GoTouchGra55/HoG/Kicad/production/bom.csv

Designator | Footprint | Quantity | Value | LCSC Part #
C1, C12, C13, C15, C16, C17, C18, C19, C2, C20, C21, C23, C26, C28, C3, C31, C33, C35, C36, C37, C4, C5, C6 | 0402 | 23 | 100nF
C10, C11, C22, C27, C38, C7 | 0603 | 6 | 10uF
C14, C34 | 0603 | 2 | 1uF
C24 | 0603 | 1 | 33uF
C25 | 0402 | 1 | 75pF
C29 | 0402 | 1 | 56pF
C30 | 0603 | 1 | 44uF
C8, C9 | 0402 | 2 | 18pF
D1, D2 | D_SOD-123 | 2 | D_Schottky
FB1 | 0603 | 1 | FerriteBead
J1 | JST_EH_S5B-EH_1x05_P2.50mm_Horizontal | 1 | DEBUG
J10 | SolderWire-0.5sqmm_1x02_P4.8mm_D0.9mm_OD2.3mm | 1 | ESC_3
J11 | SolderWire-0.5sqmm_1x02_P4.8mm_D0.9mm_OD2.3mm | 1 | ESC_4
J12 | SolderWire-0.5sqmm_1x02_P4.8mm_D0.9mm_OD2.3mm | 1 | ESC_5
J13 | SolderWire-0.5sqmm_1x02_P4.8mm_D0.9mm_OD2.3mm | 1 | ESC_6
J14 | SolderWire-0.5sqmm_1x03_P4.6mm_D0.9mm_OD2.1mm | 1 | Servos
J15 | PinHeader_1x02_P2.54mm_Horizontal | 1 | Power
J16 | PinHeader_1x03_P2.54mm_Vertical | 1 | +5V Pads
J17 | microSD_HC_Hirose_DM3AT-SF-PEJM5 | 1 | Micro_SD_Card_Det1
J18 | PinHeader_1x02_P2.54mm_Horizontal | 1 | AUX
J2 | SHOUHAN_TYPE-C_16PIN_2MD__073_ | 1 | TYPE-C_16PIN_2MD__073_
J3 | JST_EH_S6B-EH_1x06_P2.50mm_Horizontal | 1 | GPS
J4 | JST_EH_S5B-EH_1x05_P2.50mm_Horizontal | 1 | TEL
J5 | SolderWire-0.5sqmm_1x03_P4.6mm_D0.9mm_OD2.1mm | 1 | ESC[1-3]
J6 | SolderWire-0.5sqmm_1x03_P4.6mm_D0.9mm_OD2.1mm | 1 | ESC[4-6]
J7_2, J7 | AMASS_XT60-M_1x02_P7.20mm_Vertical | 2 | POWER
J8 | SolderWire-0.5sqmm_1x02_P4.8mm_D0.9mm_OD2.3mm | 1 | ESC_1
J9 | SolderWire-0.5sqmm_1x02_P4.8mm_D0.9mm_OD2.3mm | 1 | ESC_2
L1 | L_Cenker_CKCS3012 | 1 | 10uH
L2 | L_Cenker_CKCS4030 | 1 | 6.8uH
R1, R15, R16, R17, R18, R19, R20, R21, R22, R23 | 0402 | 10 | 10K
R10, R4 | 0603 | 2 | 400K
R11, R14, R6 | 0603 | 3 | 100K
R12, R5 | 0603 | 2 | 30K
R13 | 0603 | 1 | 22.1K
R2, R3 | 0402 | 2 | 5.1K
R7, R9 | 0402 | 2 | 49.9R
R8 | 0402 | 1 | 13.3K
SW1 | SW_SPDT_PCM12 | 1 | SW_SPDT
SW2 | SW_Push_SPST_NO_Alps_SKRK | 1 | SW_Push
U1 | LQFP-100_14x14mm_P0.5mm | 1 | STM32H743VITx
U2, U3 | IC_ICM-45686 | 2 | ICM-45686
U4 | BMP581 | 1 | BMP581
U5, U6 | SOT-23-6 | 2 | TPS54302
Y1 | Crystal_SMD_3225-4Pin_3.2x2.5mm | 1 | 25MHz
