GoTouchGra55/HoG/Kicad/Telemetry/production/bom.csv

Designator | Footprint | Quantity | Value | LCSC Part #
C1, C14, C28, C32, C37, C46, C5, C50, C6, C8 | 0402 | 10 | 100nF
C10, C29 | 0402 | 2 | 47nF
C11, C30 | 0402 | 2 | 47pF
C12, C13, C51, C52 | 0805 | 4 | 22uF
C15, C31 | 0402 | 2 | 3pF
C16, C34 | 0402 | 2 | 5.6pF
C17, C22, C33, C39 | 0402 | 4 | 39pF
C18, C19, C35, C45 | 0402 | 4 | 1.8pF
C2, C27 | 0603 | 2 | 10uF
C20, C44 | 0402 | 2 | 2.4pF
C21, C49 | 0603 | 2 | 100uF
C23, C24, C40, C41 | 0402 | 4 | 3.3pF
C25, C26, C38, C43 | 0402 | 4 | 1nF
C3, C4, C47, C48 | 0402 | 4 | 15pF
C36, C7 | 0603 | 2 | 1uF
C42, C9 | 0402 | 2 | 470nF
D1, D2 | 0603 | 2 | RED
J1, J5 | PinHeader_1x05_P2.54mm_Horizontal | 2 | DEBUG
J10, J9 | JST_EH_B4B-EH-A_1x04_P2.50mm_Vertical | 2 | Conn_01x04_Pin
J2, J7 | SMA_Amphenol_132134-10_Vertical | 2 | SMA
J3, J8 | PinHeader_1x02_P2.54mm_Horizontal | 2 | POWER
J4, J6 | PinHeader_1x02_P2.54mm_Horizontal | 2 | COMMS
L1, L11 | 0805 | 2 | 15uH
L10, L7 | 0402 | 2 | 9.1nH
L12, L6 | 0402 | 2 | 15nH
L2, L3 | 0402 | 2 | 47nH
L4, L8 | 0402 | 2 | 2.5nH
L5, L9 | 0402 | 2 | 4.7nH
R1, R2, R4, R5 | 0402 | 4 | 100R
R3, R6 | 0402 | 2 | 1k5
SW1, SW2, SW3, SW4 | SW_Push_SPST_NO_Alps_SKRK | 4 | RESET
U1 | TSSOP-20_4.4x6.5mm_P0.65mm | 1 | STM32C011F6Px
U2, U6 | QFN-24-1EP_4x4mm_P0.5mm_EP2.6x2.6mm | 2 | SX1262IMLTRT
U3, U8 | SOT-223-3_TabPin2 | 2 | AMS1117-3.3
U4, U7 | SOT65P215X110-6N | 2 | PE4259
U5 | LQFP-32_7x7mm_P0.8mm | 1 | STM32C031K6Tx
Y1, Y4 | Crystal_SMD_3225-4Pin_3.2x2.5mm | 2 | 48MHz
Y2, Y3 | Crystal_SMD_3225-4Pin_3.2x2.5mm | 2 | 32MHz
