GoTouchGra55/HoG/Kicad/Telemetry/HoG_Telemetry.pdf

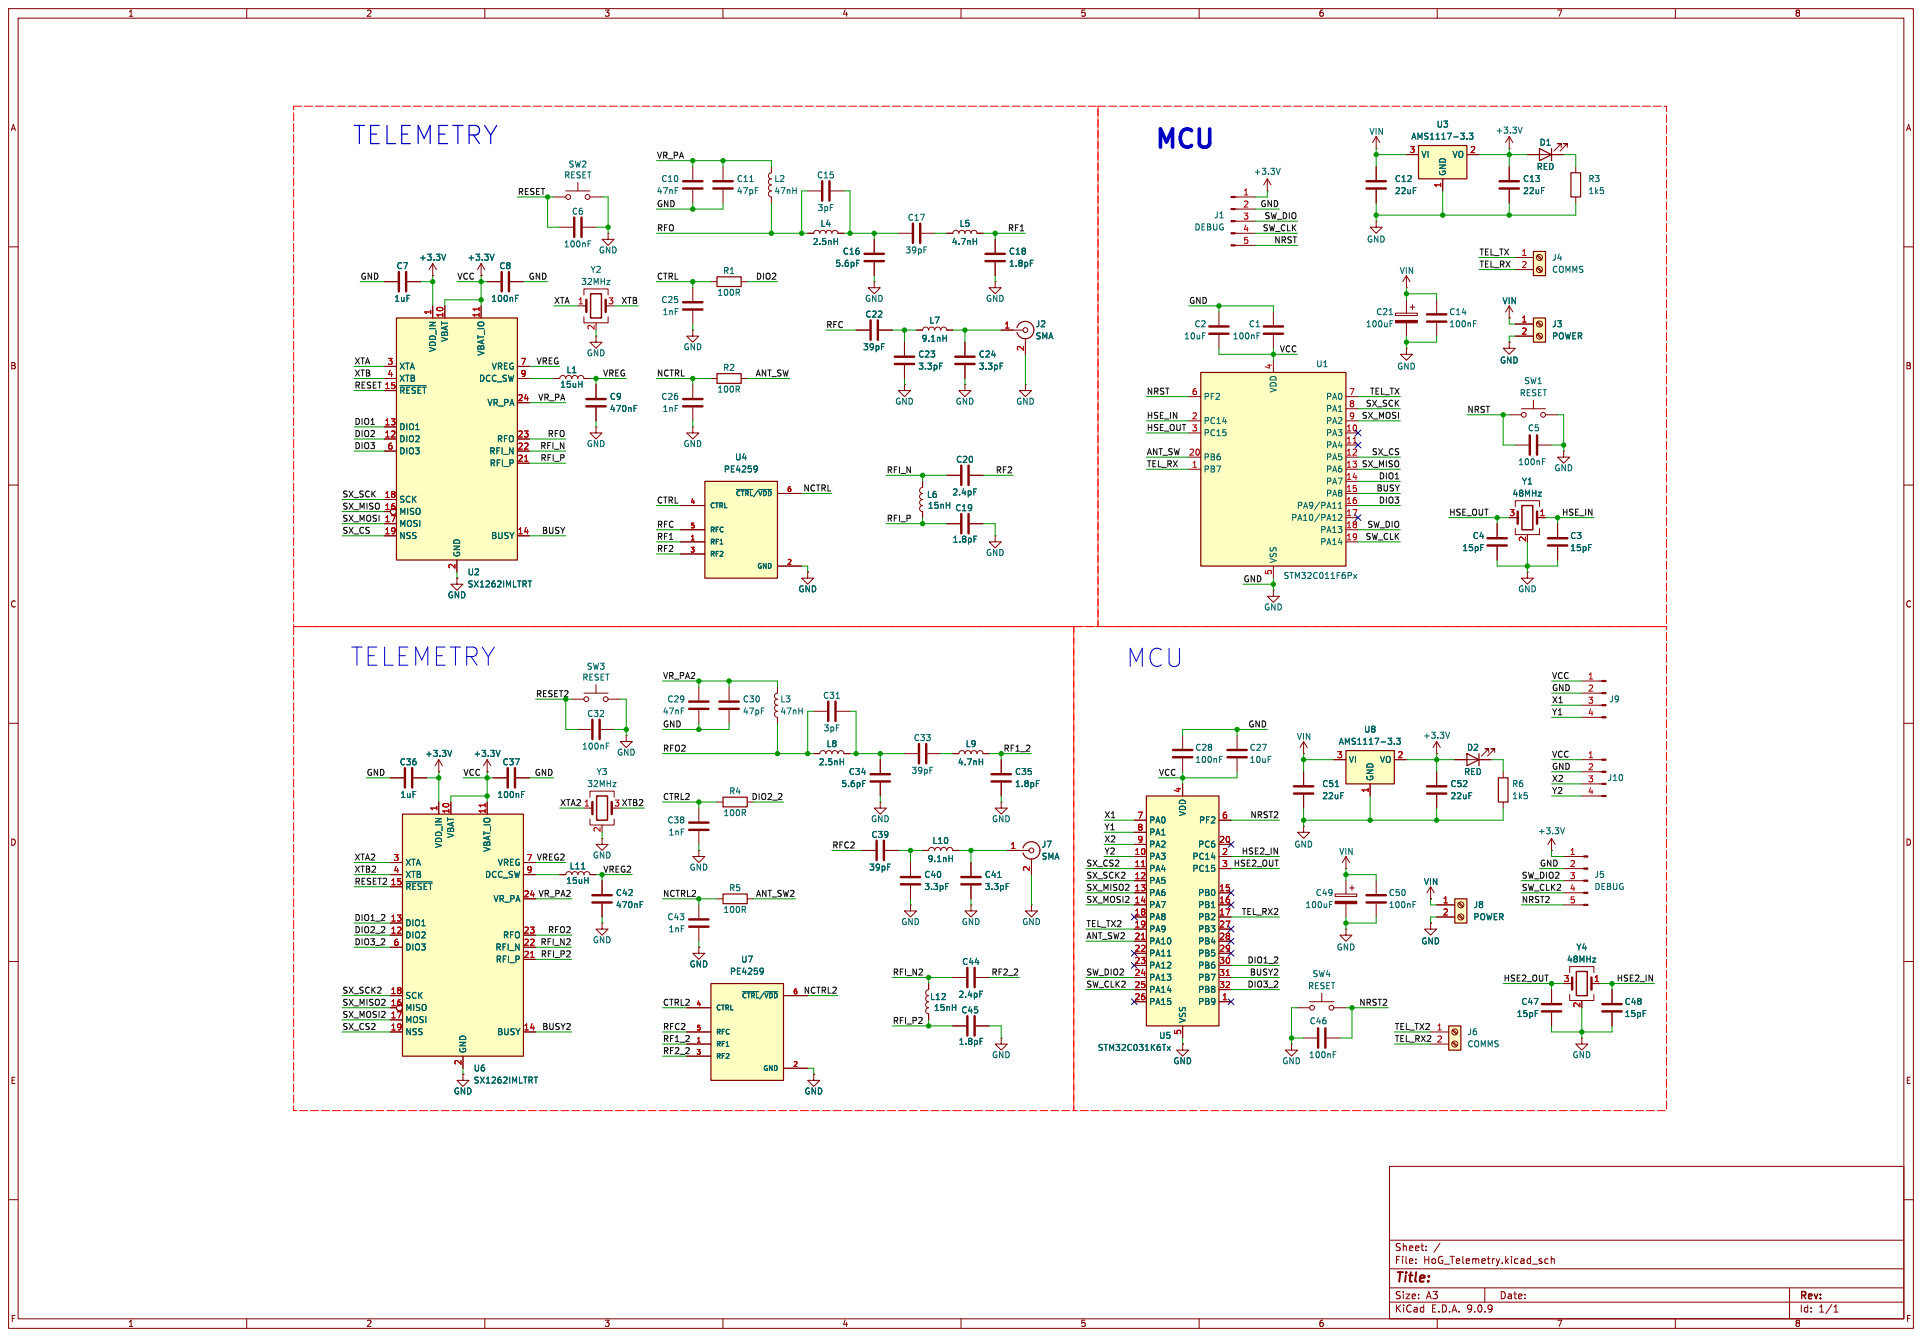
[picture p14: page 1]
