GoTouchGra55/HoG/Kicad/FC/HoG.pdf

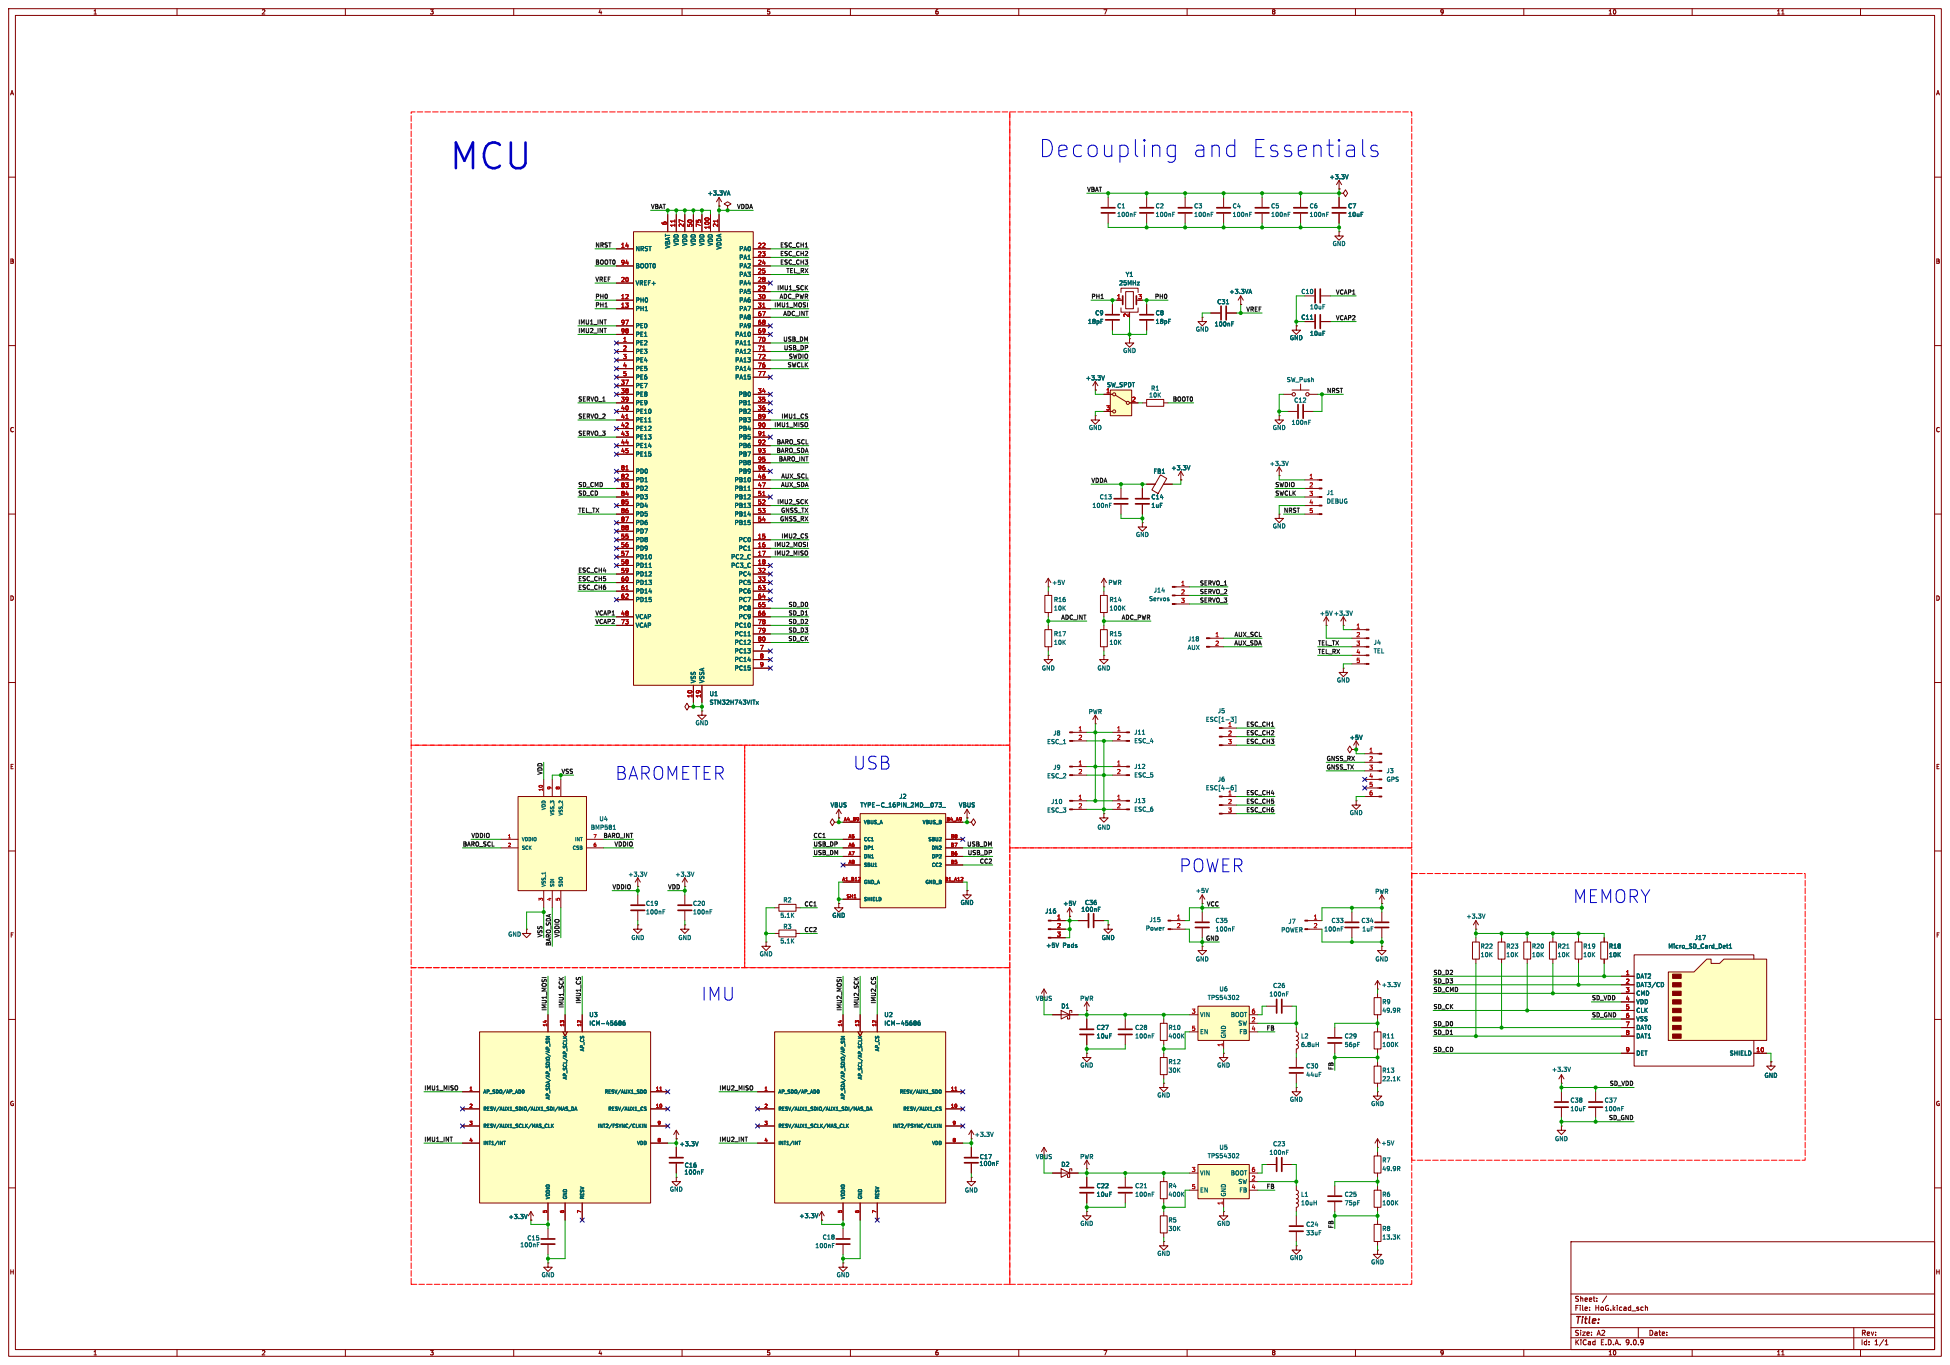
[picture p15: page 1]
