GoTouchGra55/HoG/Kicad/FC/HoG.kicad_pcb

## KiCad design Kicad/FC/HoG.kicad_pcb (2026-10-20)

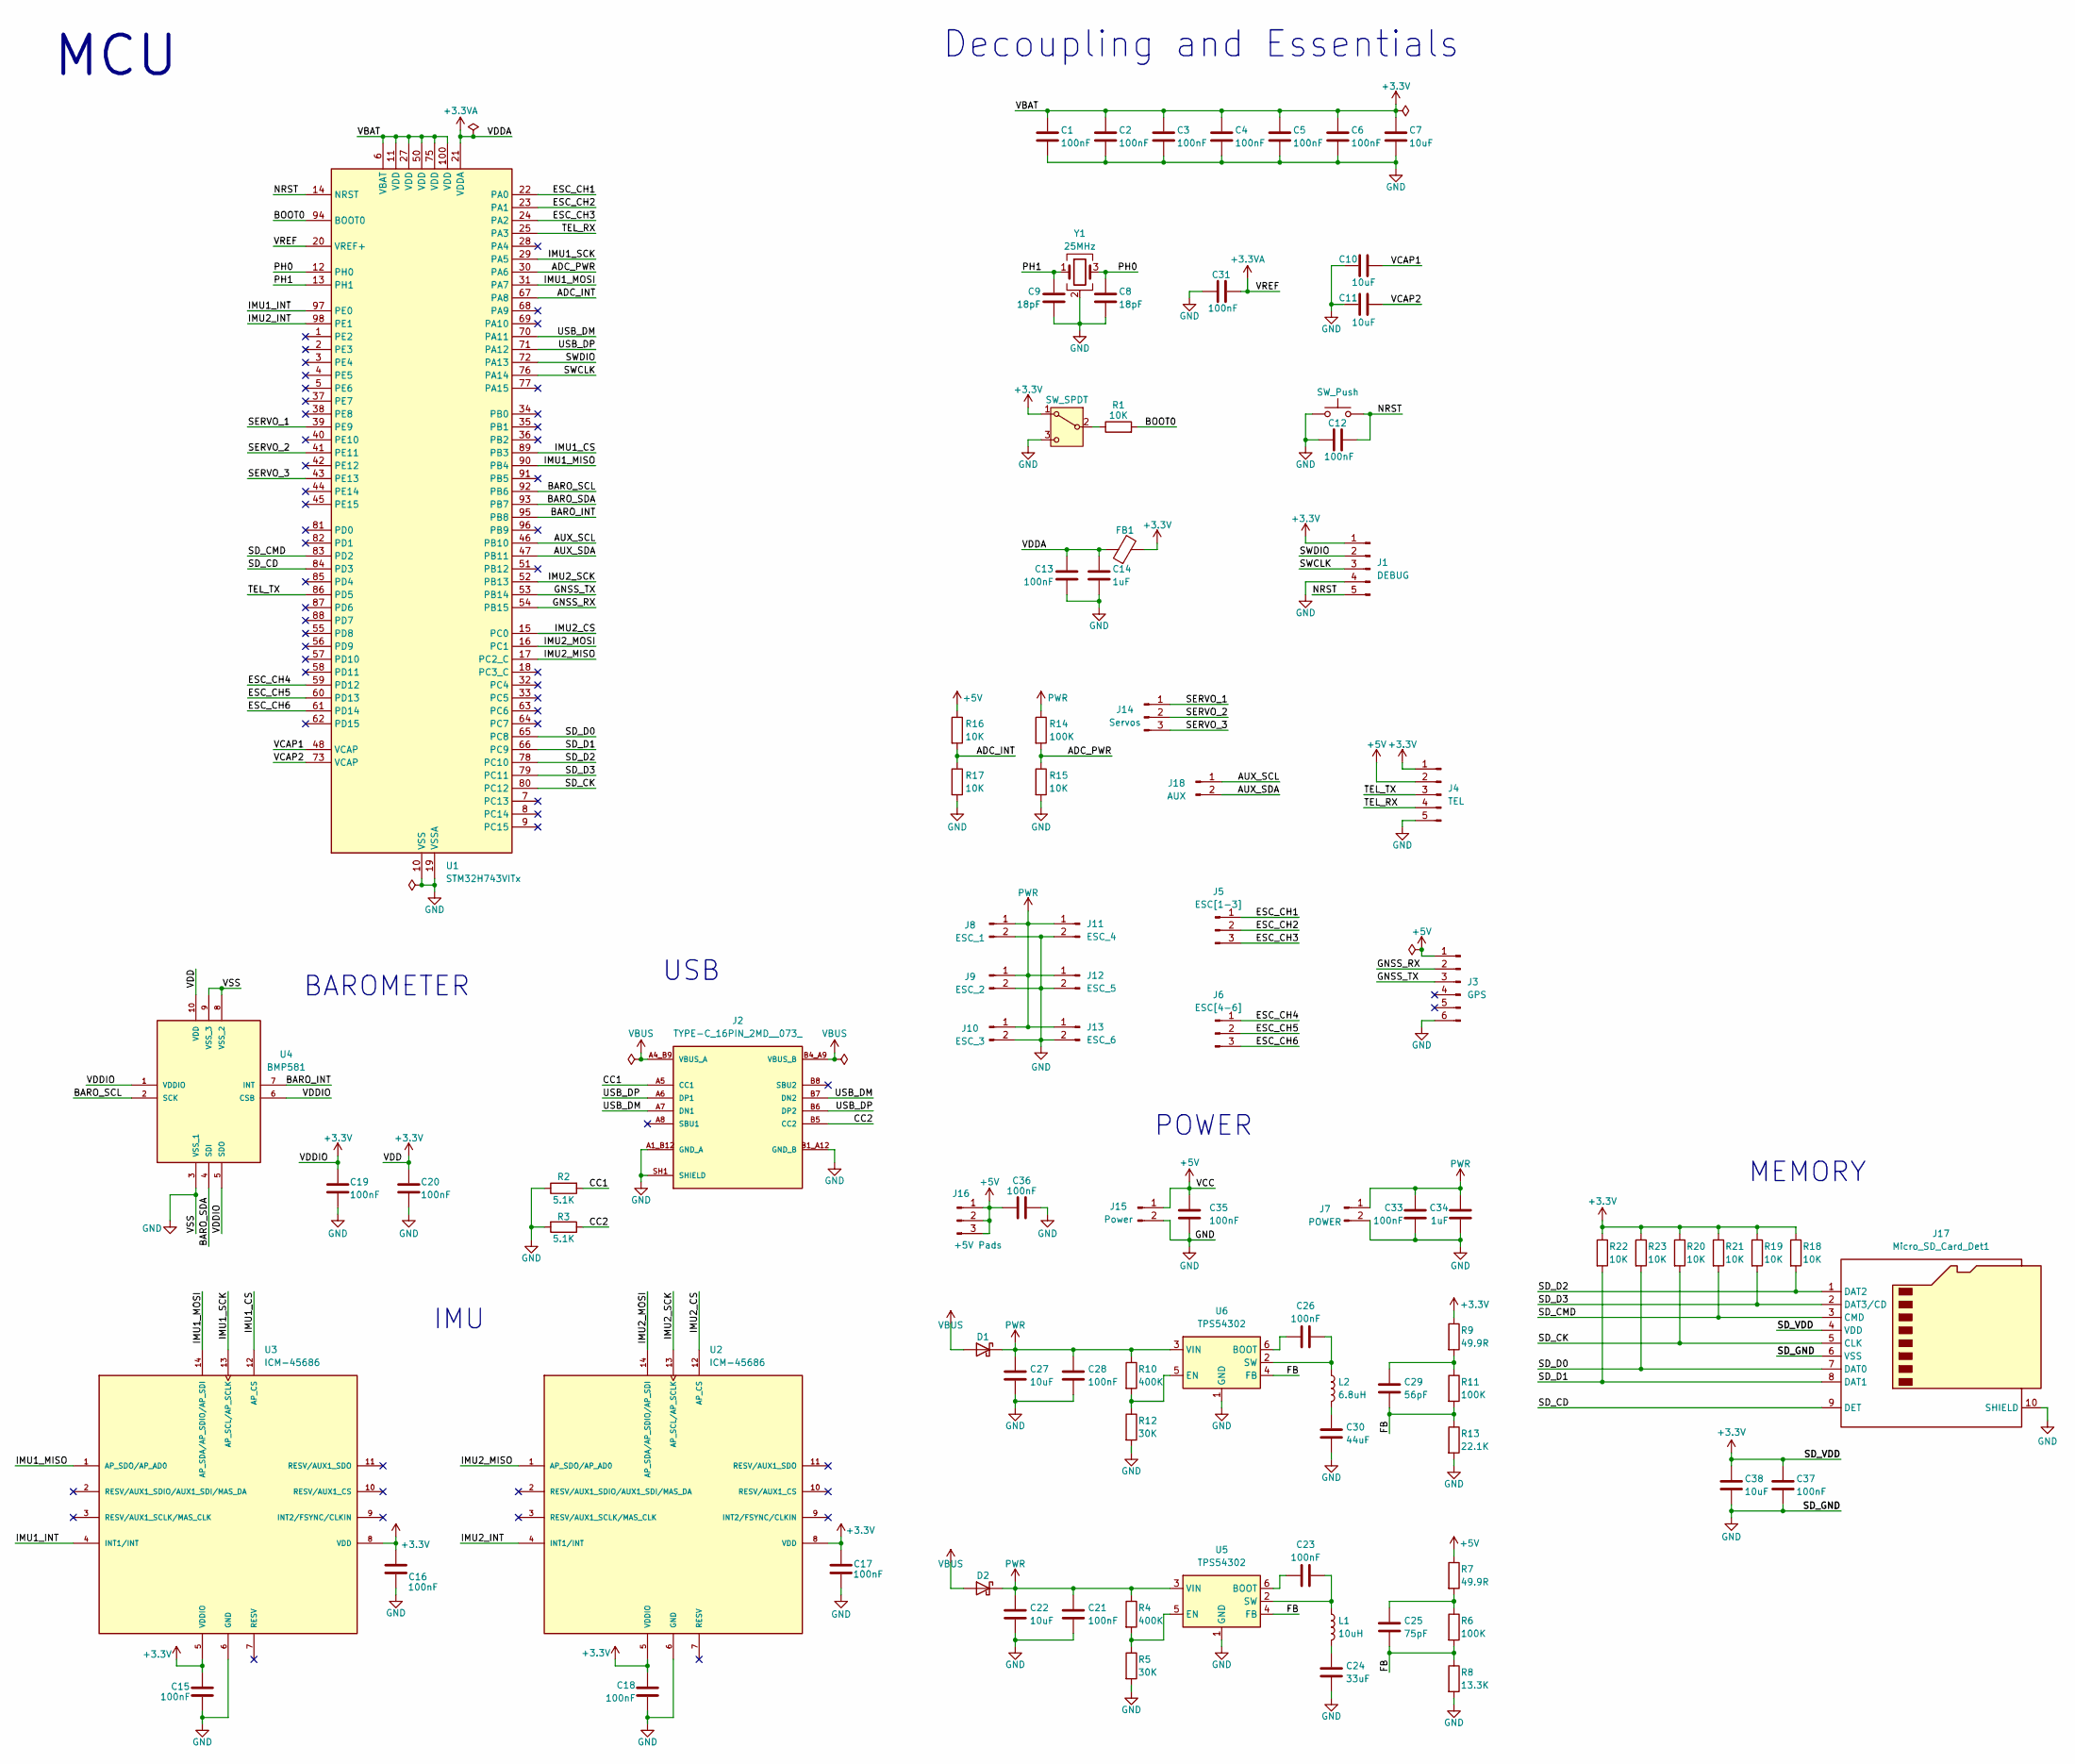
[picture p16: schematic HoG.kicad_sch]

Parts:
C1, C2, C3, C4, C5, C6, C12, C13, C15, C16, C17, C18, C19, C20, C21, C23, C26, C28, C31, C33, C35, C36, C37: 100nF; C_0402_1005Metric
C7, C10, C11, C22, C27, C38: 10uF; C_0603_1608Metric
C8, C9: 18pF; C_0402_1005Metric
C14, C34: 1uF; C_0603_1608Metric
C24: 33uF; C_0603_1608Metric
C25: 75pF; C_0402_1005Metric
C29: 56pF; C_0402_1005Metric
C30: 44uF; C_0603_1608Metric
D1, D2: D_Schottky; D_SOD-123
FB1: FerriteBead; C_0603_1608Metric
J1: DEBUG; JST_EH_S5B-EH_1x05_P2.50mm_Horizontal
J2: TYPE-C_16PIN_2MD__073_; SHOUHAN_TYPE-C_16PIN_2MD__073_; PARTREV A
J3: GPS; JST_EH_S6B-EH_1x06_P2.50mm_Horizontal
J4: TEL; JST_EH_S5B-EH_1x05_P2.50mm_Horizontal
J5: ESC[1-3]; SolderWire-0.5sqmm_1x03_P4.6mm_D0.9mm_OD2.1mm
J6: ESC[4-6]; SolderWire-0.5sqmm_1x03_P4.6mm_D0.9mm_OD2.1mm
J7: POWER; AMASS_XT60-M_1x02_P7.20mm_Vertical
J8: ESC_1; SolderWire-0.5sqmm_1x02_P4.8mm_D0.9mm_OD2.3mm
J9: ESC_2; SolderWire-0.5sqmm_1x02_P4.8mm_D0.9mm_OD2.3mm
J10: ESC_3; SolderWire-0.5sqmm_1x02_P4.8mm_D0.9mm_OD2.3mm
J11: ESC_4; SolderWire-0.5sqmm_1x02_P4.8mm_D0.9mm_OD2.3mm
J12: ESC_5; SolderWire-0.5sqmm_1x02_P4.8mm_D0.9mm_OD2.3mm
J13: ESC_6; SolderWire-0.5sqmm_1x02_P4.8mm_D0.9mm_OD2.3mm
J14: Servos; SolderWire-0.5sqmm_1x03_P4.6mm_D0.9mm_OD2.1mm
J15: Power; PinHeader_1x02_P2.54mm_Horizontal
J16: +5V Pads; PinHeader_1x03_P2.54mm_Vertical
J17: Micro_SD_Card_Det1; microSD_HC_Wuerth
J18: AUX; PinHeader_1x02_P2.54mm_Horizontal
L1: 10uH; L_Cenker_CKCS3012
L2: 6.8uH; L_Cenker_CKCS4030
R1, R15, R16, R17, R18, R19, R20, R21, R22, R23: 10K; R_0402_1005Metric
R2, R3: 5.1K; R_0402_1005Metric
R4, R10: 400K; R_0603_1608Metric
R5, R12: 30K; R_0603_1608Metric
R6, R11, R14: 100K; R_0603_1608Metric
R7, R9: 49.9R; R_0402_1005Metric
R8: 13.3K; R_0402_1005Metric
R13: 22.1K; R_0603_1608Metric
SW1: SW_SPDT; SW_SPDT_PCM12
SW2: SW_Push; SW_Push_SPST_NO_Alps_SKRK
U1: STM32H743VITx; LQFP-100_14x14mm_P0.5mm
U2, U3: ICM-45686; IC_ICM-45686
U4: BMP581; Manufacturer_Part_Number BMP581
U5, U6: TPS54302; SOT-23-6
Y1: 25MHz; Crystal_SMD_3225-4Pin_3.2x2.5mm

Connections:
+3.3V: C1.1, C2.1, C3.1, C4.1, C5.1, C6.1, C7.1, C15.2, C16.2, C17.2, C18.1, C19.1, C20.1, C37.1, C38.1, FB1.2, J1.1, J4.1, J17.4 (VDD), R9.1, R18.1, R19.1, R20.1, R21.1, R22.1, R23.1, SW1.1 (A), U1.6 (VBAT), U1.11 (VDD), U1.27 (VDD), U1.50 (VDD), U1.75 (VDD), U1.100 (VDD), U2.5 (VDDIO), U2.8 (VDD), U3.5 (VDDIO), U3.8 (VDD), U4.1 (VDDIO), U4.5 (SDO), U4.6 (CSB), U4.10 (VDD)
+3.3VA: C13.1, C14.1, C31.2, FB1.1, U1.20 (VREF+), U1.21 (VDDA)
+5V: C35.1, C36.1, J3.1, J4.2, J15.1, J16.1, J16.2, J16.3, R7.1, R16.1
/ADC_INT: R16.2, R17.1, U1.67 (PA8)
/ADC_PWR: R14.2, R15.1, U1.30 (PA6)
/AUX_SCL: J18.1, U1.46 (PB10)
/AUX_SDA: J18.2, U1.47 (PB11)
/BARO_INT: U1.95 (PB8), U4.7 (INT)
/BARO_SCL: U1.92 (PB6), U4.2 (SCK)
/BARO_SDA: U1.93 (PB7), U4.4 (SDI)
/BOOT0: R1.2, U1.94 (BOOT0)
/CC1: J2.A5 (CC1), R2.2
/CC2: J2.B5 (CC2), R3.1
/ESC_CH1: J5.1, U1.22 (PA0)
/ESC_CH2: J5.2, U1.23 (PA1)
/ESC_CH3: J5.3, U1.24 (PA2)
/ESC_CH4: J6.1, U1.59 (PD12)
/ESC_CH5: J6.2, U1.60 (PD13)
/ESC_CH6: J6.3, U1.61 (PD14)
/FB: C25.2, C29.2, R6.2, R8.1, R11.2, R13.1, U5.4 (FB), U6.4 (FB)
/GNSS_RX: J3.2, U1.54 (PB15)
/GNSS_TX: J3.3, U1.53 (PB14)
/IMU1_CS: U1.89 (PB3), U3.12 (AP_CS)
/IMU1_INT: U1.97 (PE0), U3.4 (INT1/INT)
/IMU1_MISO: U1.90 (PB4), U3.1 (AP_SDO/AP_AD0)
/IMU1_MOSI: U1.31 (PA7), U3.14 (AP_SDA/AP_SDIO/AP_SDI)
/IMU1_SCK: U1.29 (PA5), U3.13 (AP_SCL/AP_SCLK)
/IMU2_CS: U1.15 (PC0), U2.12 (AP_CS)
/IMU2_INT: U1.98 (PE1), U2.4 (INT1/INT)
/IMU2_MISO: U1.17 (PC2_C), U2.1 (AP_SDO/AP_AD0)
/IMU2_MOSI: U1.16 (PC1), U2.14 (AP_SDA/AP_SDIO/AP_SDI)
/IMU2_SCK: U1.52 (PB13), U2.13 (AP_SCL/AP_SCLK)
/NRST: C12.2, J1.5, SW2.2, U1.14 (NRST)
/PH0: C8.1, U1.12 (PH0), Y1.3
/PH1: C9.1, U1.13 (PH1), Y1.1
/SD_CD: J17.9 (DET), U1.84 (PD3)
/SD_CK: J17.5 (CLK), R20.2, U1.80 (PC12)
/SD_CMD: J17.3 (CMD), R21.2, U1.83 (PD2)
/SD_D0: J17.7 (DAT0), R23.2, U1.65 (PC8)
/SD_D1: J17.8 (DAT1), R22.2, U1.66 (PC9)
/SD_D2: J17.1 (DAT2), R18.2, U1.78 (PC10)
/SD_D3: J17.2 (DAT3/CD), R19.2, U1.79 (PC11)
/SERVO_1: J14.1, U1.39 (PE9)
/SERVO_2: J14.2, U1.41 (PE11)
/SERVO_3: J14.3, U1.43 (PE13)
/SWCLK: J1.3, U1.76 (PA14)
/SWDIO: J1.2, U1.72 (PA13)
/TEL_RX: J4.4, U1.25 (PA3)
/TEL_TX: J4.3, U1.86 (PD5)
/USB_DM: J2.A7 (DN1), J2.B7 (DN2), U1.70 (PA11)
/USB_DP: J2.A6 (DP1), J2.B6 (DP2), U1.71 (PA12)
/VCAP1: C10.2, U1.48 (VCAP)
/VCAP2: C11.1, U1.73 (VCAP)
GND: C1.2, C2.2, C3.2, C4.2, C5.2, C6.2, C7.2, C8.2, C9.2, C10.1, C11.2, C12.1, C13.2, C14.2, C15.1, C16.1, C17.1, C18.2, C19.2, C20.2, C21.2, C22.2, C24.2, C27.2, C28.2, C30.2, C31.1, C33.2, C34.2, C35.2, C36.2, C37.2, C38.2, J1.4, J2.A1_B12 (GND_A), J2.B1_A12 (GND_B), J2.SH1 (SHIELD), J2.SH2 (SHIELD), J2.SH3 (SHIELD), J2.SH4 (SHIELD), J3.6, J4.5, J7.2, J8.2, J9.2, J10.2, J11.2, J12.2, J13.2, J15.2, J17.6 (VSS), J17.10 (SHIELD), R2.1, R3.2, R5.2, R8.2, R12.2, R13.2, R15.2, R17.2, SW1.3 (C), SW2.1, U1.10 (VSS), U1.19 (VSSA), U1.26 (VSS), U1.49 (VSS), U1.74 (VSS), U1.99 (VSS), U2.6 (GND), U3.6 (GND), U4.3 (VSS_1), U4.8 (VSS_2), U4.9 (VSS_3), U5.1 (GND), U6.1 (GND), Y1.2 (G), Y1.4 (G); also elsewhere on the board
unnamed: C24.1, L1.2
unnamed: C25.1, R6.1, R7.2
unnamed: C29.1, R9.2, R11.1
unnamed: C30.1, L2.2
unnamed: R1.1, SW1.2 (B)
unnamed: C23.1, U5.6 (BOOT)
unnamed: R4.2, R5.1, U5.5 (EN)
unnamed: C23.2, L1.1, U5.2 (SW)
unnamed: C26.1, U6.6 (BOOT)
unnamed: R10.2, R12.1, U6.5 (EN)
unnamed: C26.2, L2.1, U6.2 (SW)
PWR: C21.1, C22.1, C27.1, C28.1, C33.1, C34.1, D1.1 (K), D2.1 (K), J7.1, J8.1, J9.1, J10.1, J11.1, J12.1, J13.1, R4.1, R10.1, R14.1, U5.3 (VIN), U6.3 (VIN); also elsewhere on the board
VBUS: D1.2 (A), D2.2 (A), J2.A4_B9 (VBUS_A), J2.B4_A9 (VBUS_B)

Notes on the sheet:
IMU
USB
MEMORY
MCU
BAROMETER
POWER
Decoupling and Essentials

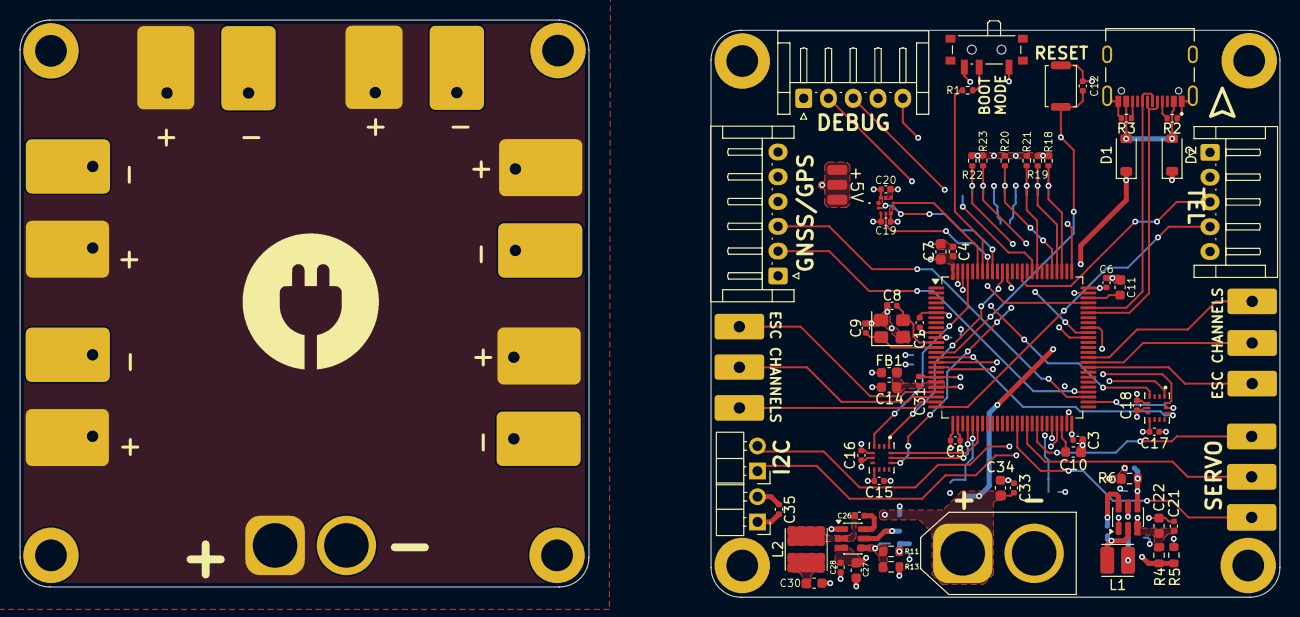
[picture p17: board HoG.kicad_pcb from above]

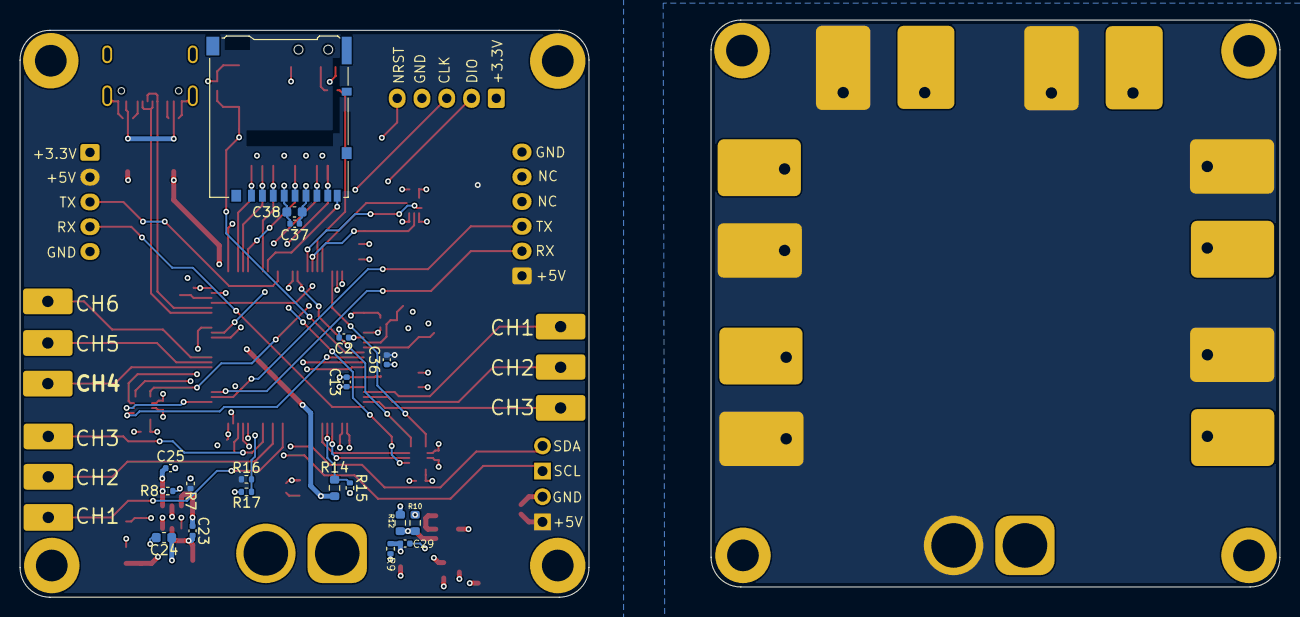
[picture p18: board HoG.kicad_pcb from below]

Board: 4 copper layers, 57.4 x 57.2 mm, 93 parts (19 on the bottom side), 67 nets.

Other parts of the board:
J7#2: POWER; AMASS_XT60-M_1x02_P7.20mm_Vertical

Their connections:
GND: J7#2.2; also elsewhere on the board
PWR: J7#2.1; also elsewhere on the board
