GoTouchGra55/HoG/Kicad/Telemetry/HoG_Telemetry.kicad_pcb

## KiCad design Kicad/Telemetry/HoG_Telemetry.kicad_pcb (2026-10-20)

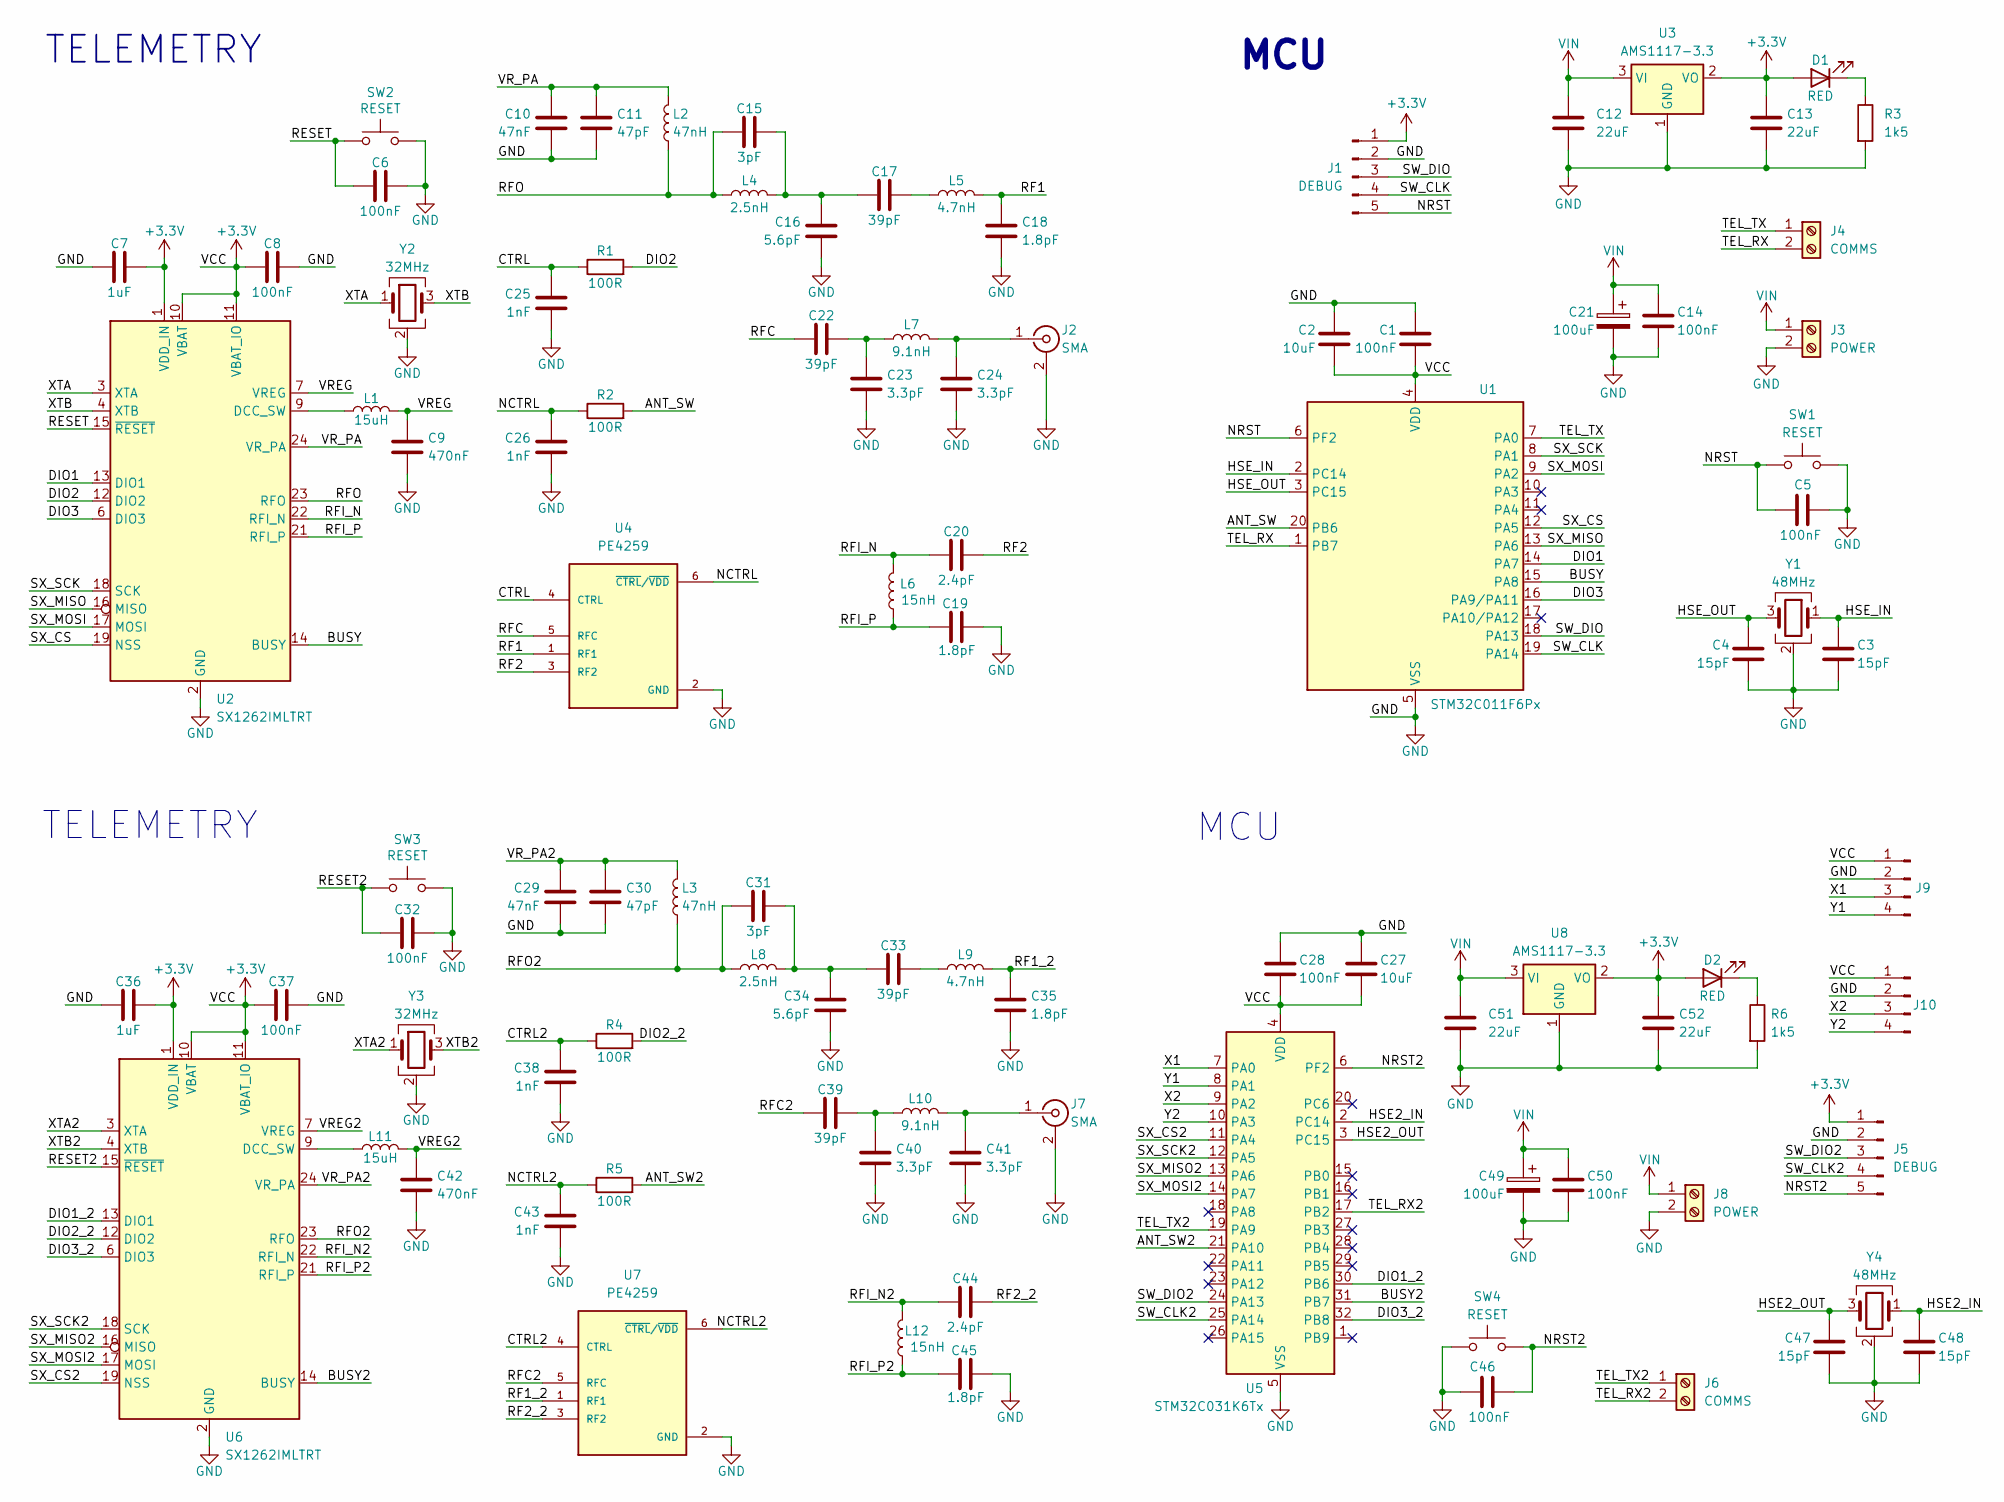
[picture p19: schematic HoG_Telemetry.kicad_sch]

Parts:
C1, C5, C6, C8, C14, C28, C32, C37, C46, C50: 100nF; C_0402_1005Metric
C2, C27: 10uF; C_0603_1608Metric
C3, C4, C47, C48: 15pF; C_0402_1005Metric
C7, C36: 1uF; C_0603_1608Metric
C9, C42: 470nF; C_0402_1005Metric
C10, C29: 47nF; C_0402_1005Metric
C11, C30: 47pF; C_0402_1005Metric
C12, C13, C51, C52: 22uF; C_0805_2012Metric
C15, C31: 3pF; C_0402_1005Metric
C16, C34: 5.6pF; C_0402_1005Metric
C17, C22, C33, C39: 39pF; C_0402_1005Metric
C18, C19, C35, C45: 1.8pF; C_0402_1005Metric
C20, C44: 2.4pF; C_0402_1005Metric
C21, C49: 100uF; C_0603_1608Metric
C23, C24, C40, C41: 3.3pF; C_0402_1005Metric
C25, C26, C38, C43: 1nF; C_0402_1005Metric
D1, D2: RED; LED_0603_1608Metric
J1, J5: DEBUG; PinHeader_1x05_P2.54mm_Horizontal
J2, J7: SMA; SMA_Amphenol_132134-10_Vertical
J3, J8: POWER; PinHeader_1x02_P2.54mm_Horizontal
J4, J6: COMMS; PinHeader_1x02_P2.54mm_Horizontal
J9, J10: Conn_01x04_Pin; JST_EH_B4B-EH-A_1x04_P2.50mm_Vertical
L1, L11: 15uH; L_0805_2012Metric
L2, L3: 47nH; L_0402_1005Metric
L4, L8: 2.5nH; L_0402_1005Metric
L5, L9: 4.7nH; L_0402_1005Metric
L6, L12: 15nH; L_0402_1005Metric
L7, L10: 9.1nH; L_0402_1005Metric
R1, R2, R4, R5: 100R; R_0402_1005Metric
R3, R6: 1k5; R_0402_1005Metric
SW1, SW2, SW3, SW4: RESET; SW_Push_SPST_NO_Alps_SKRK
U1: STM32C011F6Px; TSSOP-20_4.4x6.5mm_P0.65mm
U2, U6: SX1262IMLTRT; QFN-24-1EP_4x4mm_P0.5mm_EP2.6x2.6mm
U3, U8: AMS1117-3.3; SOT-223-3_TabPin2
U4, U7: PE4259; SOT65P215X110-6N
U5: STM32C031K6Tx; LQFP-32_7x7mm_P0.8mm
Y1, Y4: 48MHz; Crystal_SMD_3225-4Pin_3.2x2.5mm
Y2, Y3: 32MHz; Crystal_SMD_3225-4Pin_3.2x2.5mm

Connections:
+3.3V: C1.2, C2.2, C7.2, C8.1, C13.1, C27.2, C28.2, C36.2, C37.1, C52.1, D1.2 (A), D2.2 (A), J1.1, J5.1, J9.1, J10.1, U1.4 (VDD), U2.1 (VDD_IN), U2.10 (VBAT), U2.11 (VBAT_IO), U3.2 (VO), U5.4 (VDD), U6.1 (VDD_IN), U6.10 (VBAT), U6.11 (VBAT_IO), U8.2 (VO)
/ANT_SW: R2.2, U1.20 (PB6)
/ANT_SW2: R5.2, U5.21 (PA10)
/BUSY: U1.15 (PA8), U2.14 (BUSY)
/BUSY2: U5.31 (PB7), U6.14 (BUSY)
/CTRL: C25.1, R1.1, U4.4 (CTRL)
/CTRL2: C38.1, R4.1, U7.4 (CTRL)
/DIO1: U1.14 (PA7), U2.13 (DIO1)
/DIO1_2: U5.30 (PB6), U6.13 (DIO1)
/DIO2: R1.2, U2.12 (DIO2)
/DIO2_2: R4.2, U6.12 (DIO2)
/DIO3: U1.16 (PA9/PA11), U2.6 (DIO3)
/DIO3_2: U5.32 (PB8), U6.6 (DIO3)
/HSE2_IN: C48.1, U5.2 (PC14), Y4.1
/HSE2_OUT: C47.1, U5.3 (PC15), Y4.3
/HSE_IN: C3.1, U1.2 (PC14), Y1.1
/HSE_OUT: C4.1, U1.3 (PC15), Y1.3
/NCTRL: C26.1, R2.1, U4.6 (~CTRL/~VDD)
/NCTRL2: C43.1, R5.1, U7.6 (~CTRL/~VDD)
/NRST: C5.2, J1.5, SW1.2, U1.6 (PF2)
/NRST2: C46.2, J5.5, SW4.2, U5.6 (PF2)
/RESET: C6.2, SW2.2, U2.15 (~RESET)
/RESET2: C32.2, SW3.2, U6.15 (~RESET)
/RF1: C18.1, L5.2, U4.1 (RF1)
/RF1_2: C35.1, L9.2, U7.1 (RF1)
/RF2: C20.2, U4.3 (RF2)
/RF2_2: C44.2, U7.3 (RF2)
/RFC: C22.1, U4.5 (RFC)
/RFC2: C39.1, U7.5 (RFC)
/RFI_N: C20.1, L6.2, U2.22 (RFI_N)
/RFI_N2: C44.1, L12.2, U6.22 (RFI_N)
/RFI_P: C19.1, L6.1, U2.21 (RFI_P)
/RFI_P2: C45.1, L12.1, U6.21 (RFI_P)
/RFO: C15.1, L2.1, L4.1, U2.23 (RFO)
/RFO2: C31.1, L3.1, L8.1, U6.23 (RFO)
/SW_CLK: J1.4, U1.19 (PA14)
/SW_CLK2: J5.4, U5.25 (PA14)
/SW_DIO: J1.3, U1.18 (PA13)
/SW_DIO2: J5.3, U5.24 (PA13)
/SX_CS: U1.12 (PA5), U2.19 (NSS)
/SX_CS2: U5.11 (PA4), U6.19 (NSS)
/SX_MISO: U1.13 (PA6), U2.16 (MISO)
/SX_MISO2: U5.13 (PA6), U6.16 (MISO)
/SX_MOSI: U1.9 (PA2), U2.17 (MOSI)
/SX_MOSI2: U5.14 (PA7), U6.17 (MOSI)
/SX_SCK: U1.8 (PA1), U2.18 (SCK)
/SX_SCK2: U5.12 (PA5), U6.18 (SCK)
/TEL_RX: J4.2, U1.1 (PB7)
/TEL_RX2: J6.2, U5.17 (PB2)
/TEL_TX: J4.1, U1.7 (PA0)
/TEL_TX2: J6.1, U5.19 (PA9)
/VREG: C9.1, L1.2, U2.7 (VREG)
/VREG2: C42.1, L11.2, U6.7 (VREG)
/VR_PA: C10.1, C11.1, L2.2, U2.24 (VR_PA)
/VR_PA2: C29.1, C30.1, L3.2, U6.24 (VR_PA)
/X1: J9.3, U5.7 (PA0)
/X2: J10.3, U5.9 (PA2)
/XTA: U2.3 (XTA), Y2.1
/XTA2: U6.3 (XTA), Y3.1
/XTB: U2.4 (XTB), Y2.3
/XTB2: U6.4 (XTB), Y3.3
/Y1: J9.4, U5.8 (PA1)
/Y2: J10.4, U5.10 (PA3)
GND: C1.1, C2.1, C3.2, C4.2, C5.1, C6.1, C7.1, C8.2, C9.2, C10.2, C11.2, C12.2, C13.2, C14.2, C16.2, C18.2, C19.2, C21.2, C23.2, C24.2, C25.2, C26.2, C27.1, C28.1, C29.2, C30.2, C32.1, C34.2, C35.2, C36.1, C37.2, C38.2, C40.2, C41.2, C42.2, C43.2, C45.2, C46.1, C47.2, C48.2, C49.2, C50.2, C51.2, C52.2, J1.2, J2.2 (Ext), J3.2, J5.2, J7.2 (Ext), J8.2, J9.2, J10.2, R3.2, R6.2, SW1.1, SW2.1, SW3.1, SW4.1, U1.5 (VSS), U2.2 (GND), U2.5 (GND), U2.8 (GND), U2.20 (GND), U2.25 (GND), U3.1 (GND), U4.2 (GND), U5.5 (VSS), U6.2 (GND), U6.5 (GND), U6.8 (GND), U6.20 (GND), U6.25 (GND), U7.2 (GND), U8.1 (GND), Y1.2 (G), Y1.4 (G), Y2.2 (G), Y2.4 (G), Y3.2 (G), Y3.4 (G), Y4.2 (G), Y4.4 (G)
unnamed: C15.2, C16.1, C17.1, L4.2
unnamed: C17.2, L5.1
unnamed: C22.2, C23.1, L7.1
unnamed: C31.2, C33.1, C34.1, L8.2
unnamed: C33.2, L9.1
unnamed: C39.2, C40.1, L10.1
unnamed: D1.1 (K), R3.1
unnamed: D2.1 (K), R6.1
unnamed: C24.1, J2.1 (In), L7.2
unnamed: C41.1, J7.1 (In), L10.2
unnamed: L1.1, U2.9 (DCC_SW)
unnamed: L11.1, U6.9 (DCC_SW)
VIN: C12.1, C14.1, C21.1, C49.1, C50.1, C51.1, J3.1, J8.1, U3.3 (VI), U8.3 (VI)

Notes on the sheet:
MCU
TELEMETRY

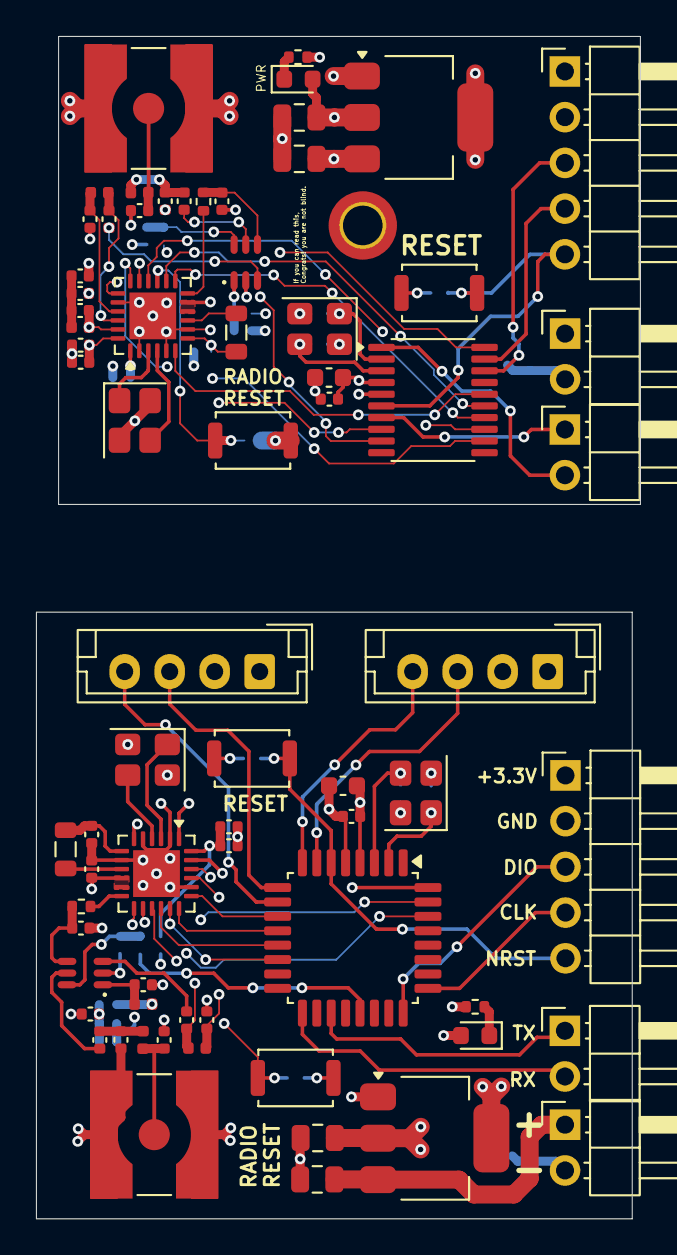
[picture p20: board HoG_Telemetry.kicad_pcb from above]

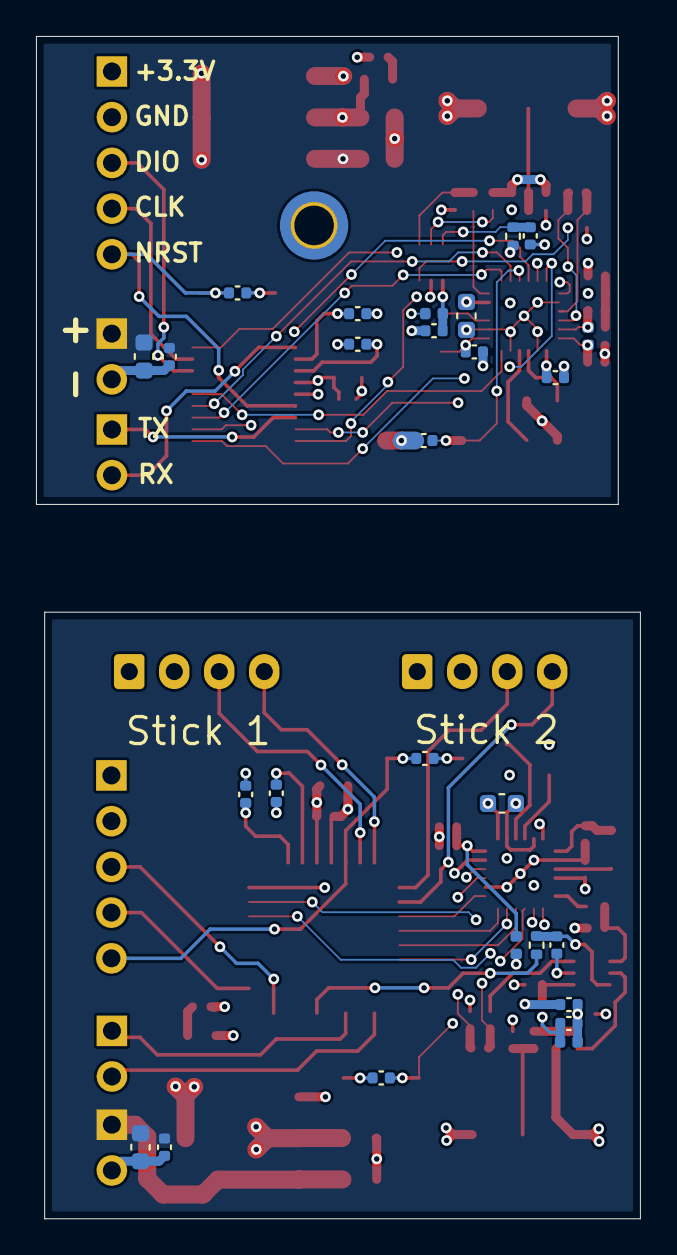
[picture p21: board HoG_Telemetry.kicad_pcb from below]

Board: 4 copper layers, 33.6 x 65.7 mm, 98 parts (27 on the bottom side), 77 nets.
