GoTouchGra55/HoG/src/HoG.ioc

Mcu.UserName=STM32H743VITx
PA0.GPIO_Label=ESC_CH1
PA0.Signal=S_TIM2_CH1_ETR
PA1.GPIO_Label=ESC_CH2
PA1.Signal=S_TIM2_CH2
PA11.Signal=USB_OTG_FS_DM
PA12.Signal=USB_OTG_FS_DP
PA2.GPIO_Label=ESC_CH3
PA2.Signal=S_TIM2_CH3
PA3.GPIO_Label=TEL_RX
PA3.Signal=USART2_RX
PA5.GPIO_Label=IMU1_SCK
PA5.Signal=SPI1_SCK
PA6.Signal=ADCx_INP3
PA7.GPIO_Label=IMU1_MOSI
PA7.Signal=SPI1_MOSI
PB10.GPIO_Label=AUX_SCL
PB10.Signal=I2C2_SCL
PB11.GPIO_Label=AUX_SDA
PB11.Signal=I2C2_SDA
PB13.GPIO_Label=IMU2_SCK
PB13.Signal=SPI2_SCK
PB14.GPIO_Label=GNSS_TX
PB14.Signal=USART1_TX
PB15.GPIO_Label=GNSS_RX
PB15.Signal=USART1_RX
PB6.GPIO_Label=BARO_SCL
PB6.Signal=I2C1_SCL
PB7.GPIO_Label=BARO_SDA
PB7.Signal=I2C1_SDA
PC1.GPIO_Label=IMU2_MOSI
PC1.Signal=SPI2_MOSI
PC10.Signal=SDMMC1_D2
PC11.Signal=SDMMC1_D3
PC12.Signal=SDMMC1_CK
PC2_C.GPIO_Label=IMU2_MISO
PC2_C.Signal=SPI2_MISO
PC4.Signal=ADCx_INP4
PC8.Signal=SDMMC1_D0
PC9.Signal=SDMMC1_D1
PD12.GPIO_Label=ESC_CH4
PD12.Signal=S_TIM4_CH1
PD13.GPIO_Label=ESC_CH5
PD13.Signal=S_TIM4_CH2
PD14.GPIO_Label=ESC_CH6
PD14.Signal=S_TIM4_CH3
PD2.Signal=SDMMC1_CMD
PD5.GPIO_Label=TEL_TX
PD5.Signal=USART2_TX
PE11.Signal=S_TIM1_CH2
PE13.Signal=S_TIM1_CH3
PE9.Signal=S_TIM1_CH1
