GoTouchGra55/HoG/(commit log)

2026-10-12 Add project files
    [HoG.kicad_pcb, HoG.kicad_sch, bom.csv, designators.csv, positions.csv]
2026-10-20 Add final files and journals
    [HoG.kicad_pcb, HoG.kicad_sch, HoG_Telemetry.kicad_pcb, HoG_Telemetry.kicad_sch, bom.csv, designators.csv, positions.csv]
2026-10-27 Add BOM.csv with item details and costs
    [BOM.csv]
2026-10-27 Fix BOM.csv formatting for total line
    [BOM.csv]
2026-10-27 Fix BOM.csv formatting by removing extra comma
    [BOM.csv]
